thopa/ADSR/README.md

# ADSR
Euroack ADSR envelope generator based on https://gist.github.com/m0xpd
Added LED as visual feedback for the envelope
14hp 30ma @ +12v
