thopa/ADSR/adsr.jpg

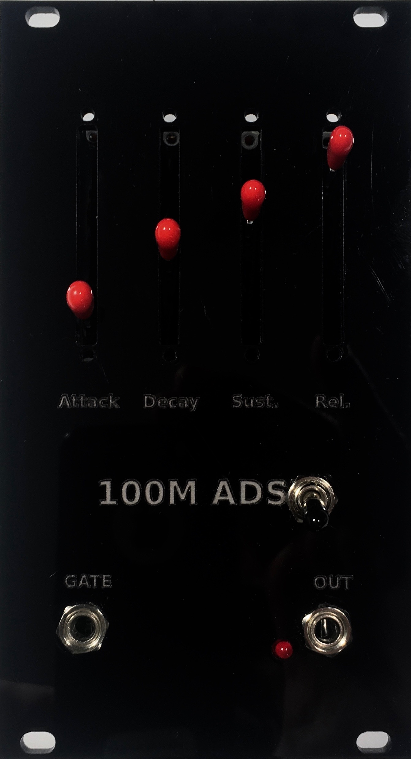
adsr.jpg
