thopa/ADSR/Roland_140_ADSR_converted_panel_drill.pdf

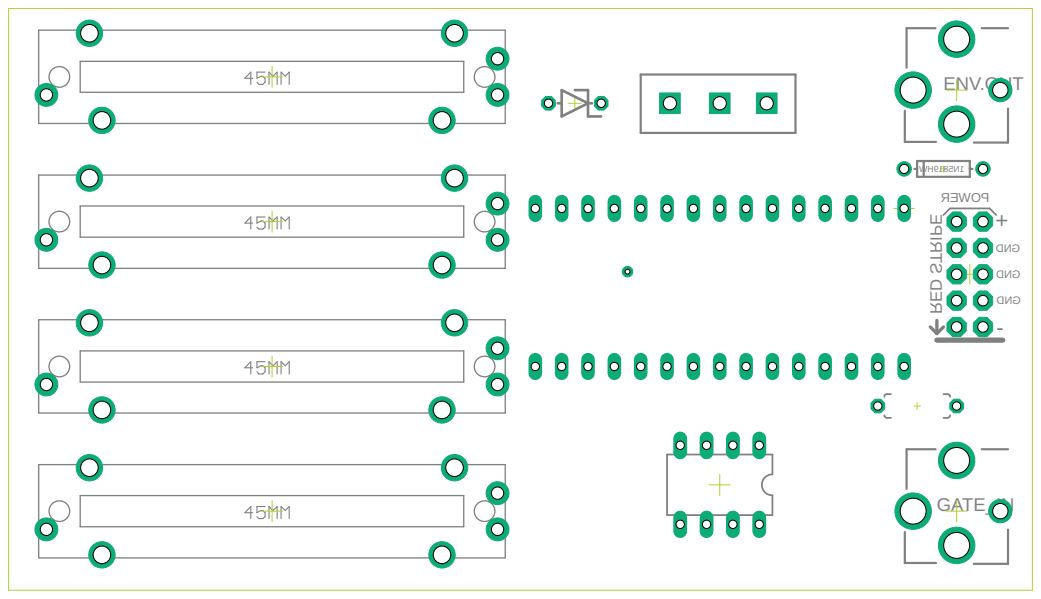
[picture p2: page 1]
