thopa/ADSR/ADSR_duino.brd

## EAGLE design ADSR_duino.brd (2019-01-15)

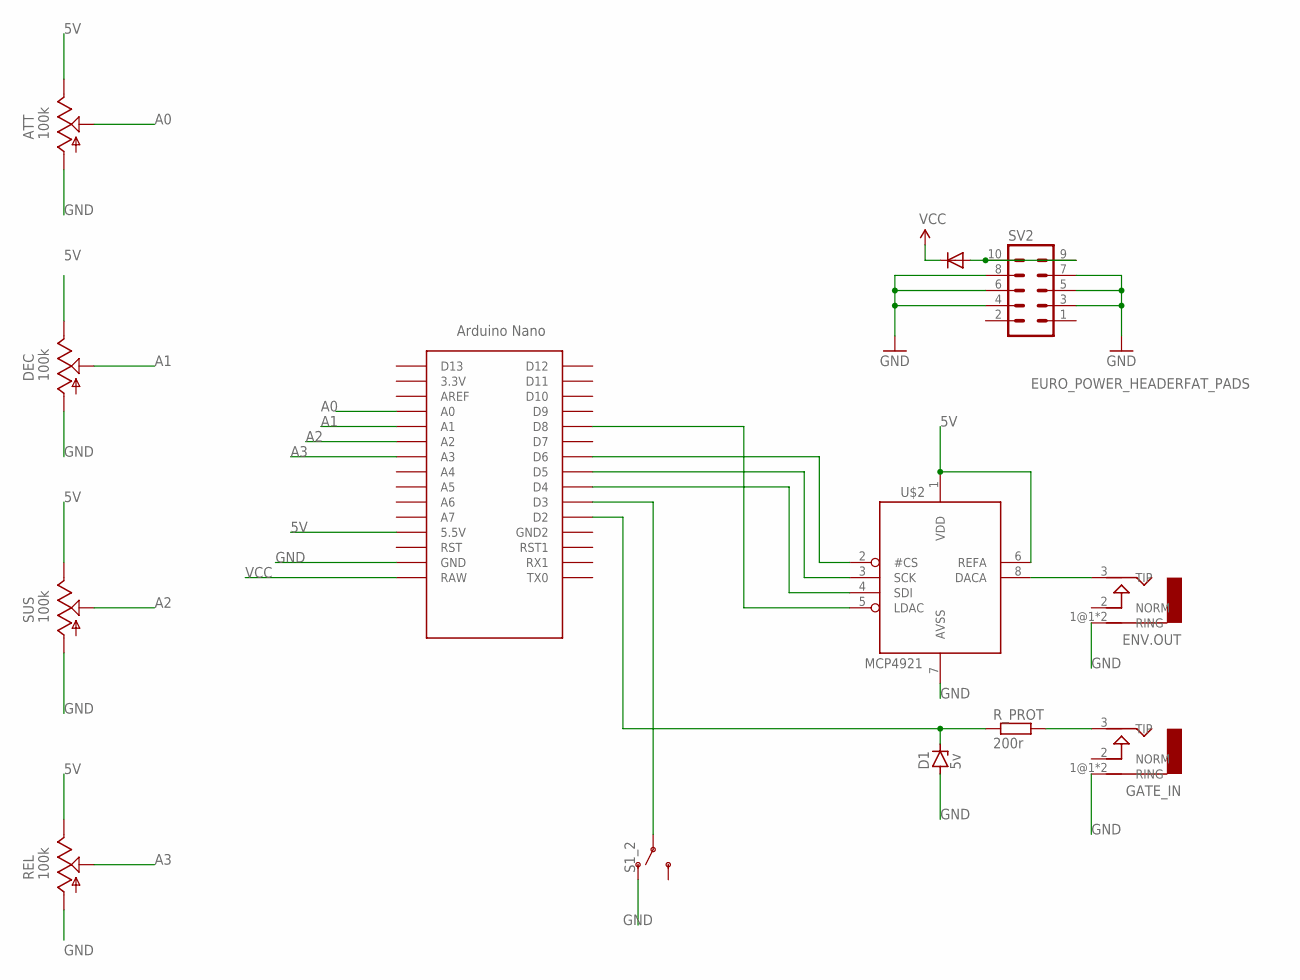
[picture p3: schematic ADSR_duino.sch]

Parts:
ATT: 100k; SLIDEPOT-45
D1: 5v; ZDIO-5
D2: 1N5819HW; DO-1N4148
DEC: 100k; SLIDEPOT-45
ENV.OUT: AUDIO-JACKERTHENVAR; ERTHENVAR-JACK
GATE_IN: AUDIO-JACKERTHENVAR; ERTHENVAR-JACK
REL: 100k; SLIDEPOT-45
R_PROT: 200r; 7MM_RESISTOR
S1_2: SWITCH-SPDT-PTH-11.6X4.0MM; SWITCH_SPDT_PTH_11.6X4.0MM
SUS: 100k; SLIDEPOT-45
SV2: EURO_POWER_HEADERFAT_PADS; EURO_PWR_HEADER_FAT
U$1: NANO
U$2: MCP4921; DIL08

Connections:
5V: ATT.B, DEC.B, REL.B, SUS.B, U$1.5V (5.5V), U$2.1 (VDD), U$2.6 (REFA)
A0: ATT.WIPER, U$1.A0
A1: DEC.WIPER, U$1.A1
A2: SUS.WIPER, U$1.A2
A3: REL.WIPER, U$1.A3
GND: ATT.A, D1.A, DEC.A, ENV.OUT.1@1 (RING), ENV.OUT.1@2 (RING), GATE_IN.1@1 (RING), GATE_IN.1@2 (RING), REL.A, S1_2.1 (O), SUS.A, SV2.3, SV2.4, SV2.5, SV2.6, SV2.7, SV2.8, U$1.GND, U$2.7 (AVSS)
unnamed: D2.A, SV2.9, SV2.10
unnamed: S1_2.2, U$1.D3
unnamed: GATE_IN.3 (TIP), R_PROT.2
unnamed: ENV.OUT.3 (TIP), U$2.8 (DACA)
unnamed: D1.C, R_PROT.1, U$1.D2
unnamed: U$1.D4, U$2.4 (SDI)
unnamed: U$1.D5, U$2.3 (SCK)
unnamed: U$1.D6, U$2.2 (#CS)
unnamed: U$1.D8, U$2.5 (LDAC)
VCC: D2.C, U$1.RAW

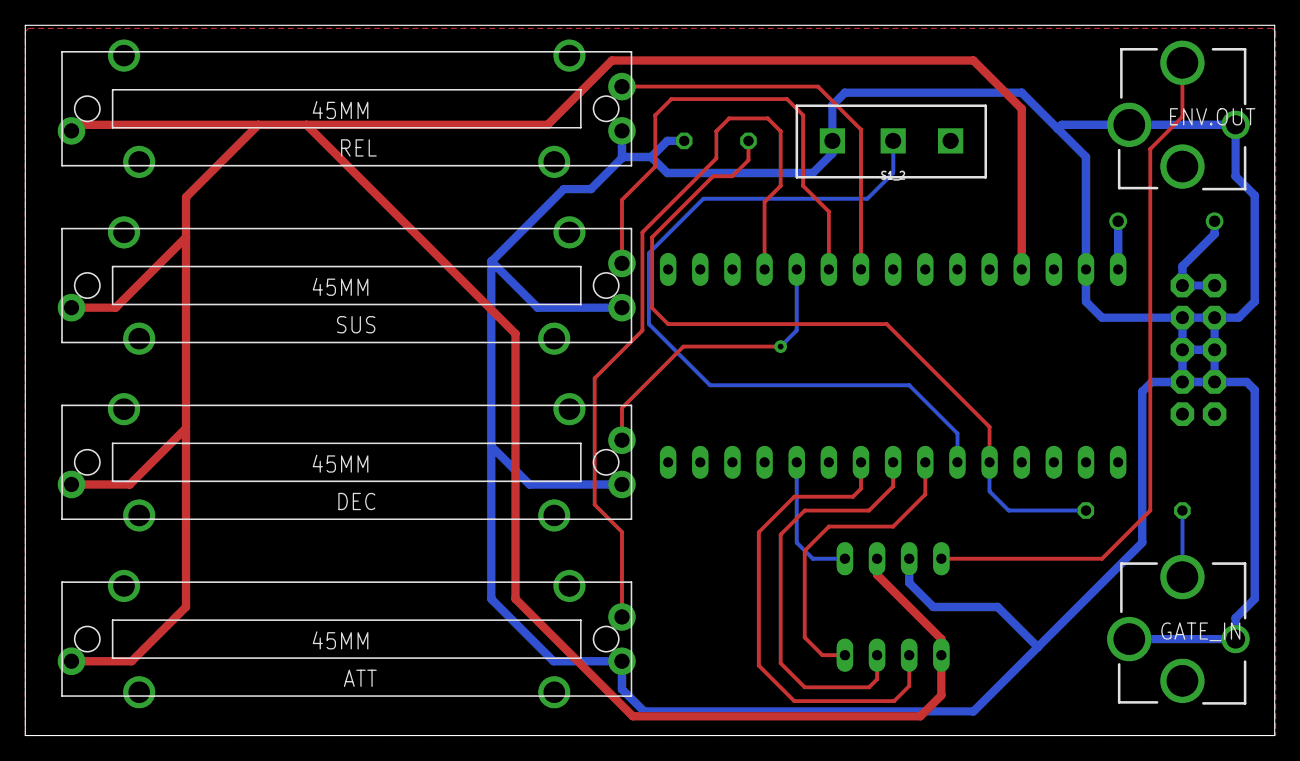
[picture p4: board ADSR_duino.brd from above]

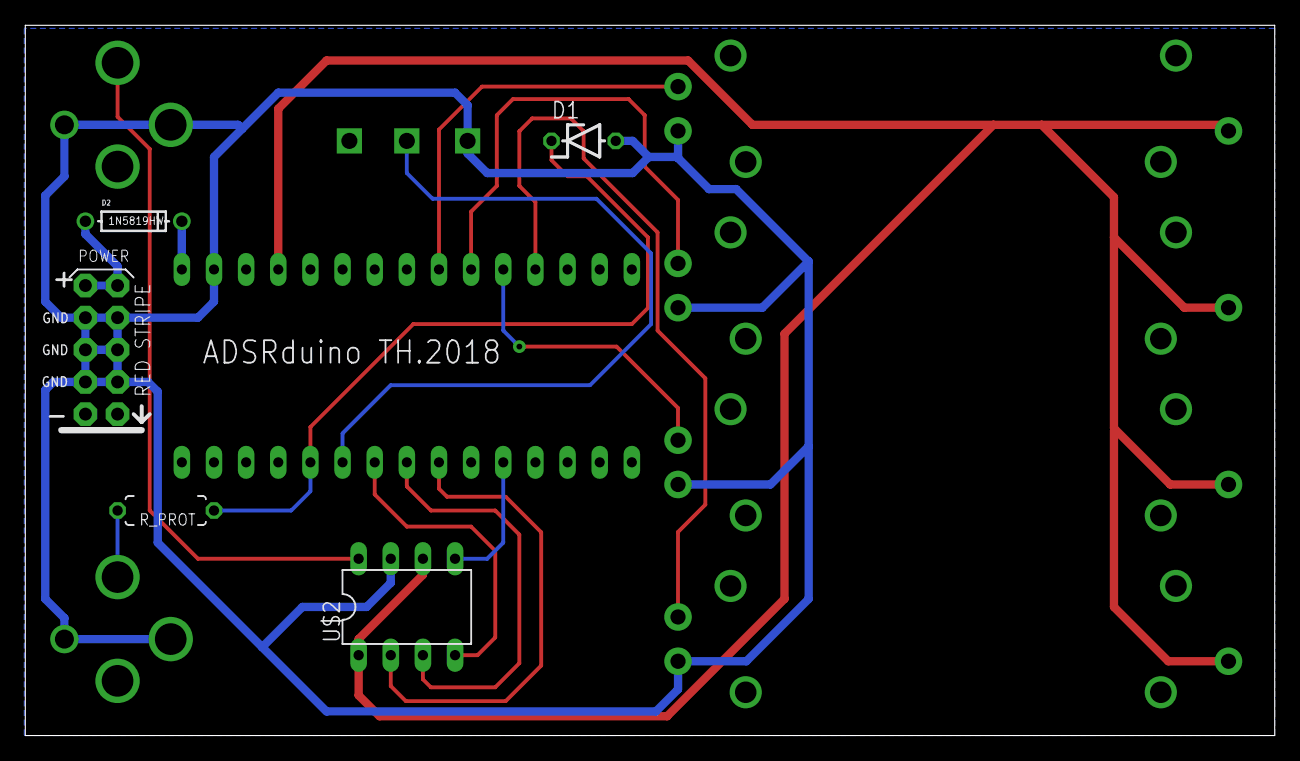
[picture p5: board ADSR_duino.brd from below]

Board: 2 copper layers, 98.7 x 56.1 mm, 13 parts (6 on the bottom side), 16 nets.
