thopa/ADSR/(notices)

Notices in the files:
parts and their libraries:
SPDT_Switches_Thonk: Licensing: Creative Commons ShareAlike 4.0 International - https://creativecommons.org/licenses/by-sa/4.0
